Bharathi-DotNet/-Alarm-v1-Esp32/hardware/kicad/pcb_bottom_3d.png

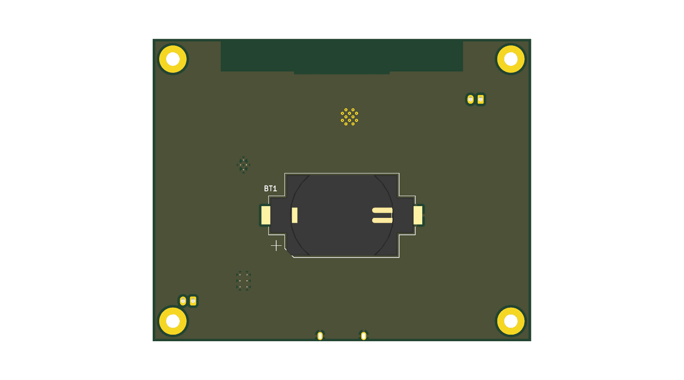
hardware/kicad/pcb_bottom_3d.png
