Bharathi-DotNet/-Alarm-v1-Esp32/hardware/kicad/pcb_top_3d.png

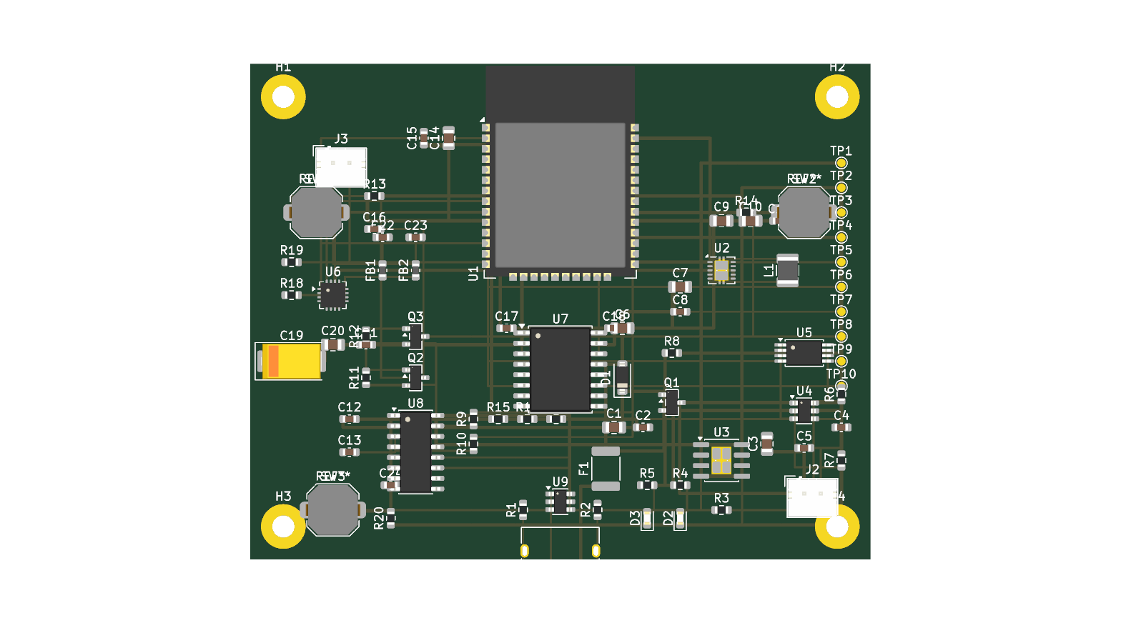
hardware/kicad/pcb_top_3d.png
