Bharathi-DotNet/-Alarm-v1-Esp32/hardware/kicad/alarm_clock_v1_bom.csv

Refs | Value | Footprint | Qty | DNP
BT1 | CR2032 (3V) | Battery:BatteryHolder_Keystone_1060_1x2032 | 1
C1 | 10uF | Capacitor_SMD:C_0805_2012Metric | 1
C2 | 100nF | Capacitor_SMD:C_0603_1608Metric | 1
C3 | 10uF | Capacitor_SMD:C_0805_2012Metric | 1
C4 | 100nF | Capacitor_SMD:C_0603_1608Metric | 1
C5 | 100nF | Capacitor_SMD:C_0603_1608Metric | 1
C6 | 22uF | Capacitor_SMD:C_0805_2012Metric | 1
C7 | 10uF | Capacitor_SMD:C_0805_2012Metric | 1
C8 | 100nF | Capacitor_SMD:C_0603_1608Metric | 1
C9 | 10uF | Capacitor_SMD:C_0805_2012Metric | 1
C10 | 10uF | Capacitor_SMD:C_0805_2012Metric | 1
C11 | 100nF | Capacitor_SMD:C_0603_1608Metric | 1
C12 | 100nF | Capacitor_SMD:C_0603_1608Metric | 1
C13 | 100nF | Capacitor_SMD:C_0603_1608Metric | 1
C14 | 10uF | Capacitor_SMD:C_0805_2012Metric | 1
C15 | 100nF | Capacitor_SMD:C_0603_1608Metric | 1
C16 | 1uF (POR Delay) | Capacitor_SMD:C_0603_1608Metric | 1
C17 | 100nF | Capacitor_SMD:C_0603_1608Metric | 1
C18 | 100nF | Capacitor_SMD:C_0603_1608Metric | 1
C19 | 220uF Low-ESR | Capacitor_Tantalum_SMD:CP_EIA-7343-31_Kemet-D | 1
C20 | 10uF | Capacitor_SMD:C_0805_2012Metric | 1
C21 | 100nF | Capacitor_SMD:C_0603_1608Metric | 1
C22 | 100pF | Capacitor_SMD:C_0603_1608Metric | 1
C23 | 100pF | Capacitor_SMD:C_0603_1608Metric | 1
C24 | 100nF (Debounce) | Capacitor_SMD:C_0603_1608Metric | 1
D1 | SS34 (3A/40V) | Diode_SMD:D_SOD-123 | 1
D2 | RED (CHRG) | LED_SMD:LED_0603_1608Metric | 1
D3 | GRN (FULL) | LED_SMD:LED_0603_1608Metric | 1
F1 | 500mA PTC | Fuse:Fuse_1812_4532Metric | 1
FB1 | 220R@100MHz | Inductor_SMD:L_0603_1608Metric | 1
FB2 | 220R@100MHz | Inductor_SMD:L_0603_1608Metric | 1
J1 | USB_C_16P | Connector_USB:USB_C_Receptacle_HRO_TYPE-C-31-M-12 | 1
J2 | JST_PH_BATT | Connector_JST:JST_PH_B2B-PH-K_1x02_P2.00mm_Vertical | 1
J3 | Speaker_4R_3W | Connector_JST:JST_PH_B2B-PH-K_1x02_P2.00mm_Vertical | 1
L1 | 2.2uH (2.5A) | Inductor_SMD:L_1210_3225Metric | 1
Q1 | AO3401A | Package_TO_SOT_SMD:SOT-23 | 1
Q2 | MMBT3904 | Package_TO_SOT_SMD:SOT-23 | 1
Q3 | MMBT3904 | Package_TO_SOT_SMD:SOT-23 | 1
R1 | 5.1k (CC1) | Resistor_SMD:R_0603_1608Metric | 1
R2 | 5.1k (CC2) | Resistor_SMD:R_0603_1608Metric | 1
R3 | 4.7k (255mA) | Resistor_SMD:R_0603_1608Metric | 1
R4 | 1k | Resistor_SMD:R_0603_1608Metric | 1
R5 | 1k | Resistor_SMD:R_0603_1608Metric | 1
R6 | 100R | Resistor_SMD:R_0603_1608Metric | 1
R7 | 1k | Resistor_SMD:R_0603_1608Metric | 1
R8 | 100k (Gate PD) | Resistor_SMD:R_0603_1608Metric | 1
R9 | 1k | Resistor_SMD:R_0603_1608Metric | 1
R10 | 1k | Resistor_SMD:R_0603_1608Metric | 1
R11 | 10k | Resistor_SMD:R_0603_1608Metric | 1
R12 | 10k | Resistor_SMD:R_0603_1608Metric | 1
R13 | 10k (EN Pullup) | Resistor_SMD:R_0603_1608Metric | 1
R14 | 10k (BOOT Pullup) | Resistor_SMD:R_0603_1608Metric | 1
R15 | 4.7k | Resistor_SMD:R_0603_1608Metric | 1
R16 | 4.7k | Resistor_SMD:R_0603_1608Metric | 1
R17 | 10k | Resistor_SMD:R_0603_1608Metric | 1
R18 | 100k (12dB Gain) | Resistor_SMD:R_0603_1608Metric | 1
R19 | 100k (SD Pull-Down) | Resistor_SMD:R_0603_1608Metric | 1
R20 | 10k (WAKE Pullup) | Resistor_SMD:R_0603_1608Metric | 1
SW1 | RESET | Button_Switch_SMD:SW_Push_1TS009xxxx-xxxx-xxxx_6x6x5mm | 1
SW2 | BOOT | Button_Switch_SMD:SW_Push_1TS009xxxx-xxxx-xxxx_6x6x5mm | 1
SW3 | WAKE_BTN | Button_Switch_SMD:SW_Push_1TS009xxxx-xxxx-xxxx_6x6x5mm | 1
TP1 | VBUS | TestPoint:TestPoint_Pad_D1.0mm | 1
TP2 | VBAT_PROT | TestPoint:TestPoint_Pad_D1.0mm | 1
TP3 | VSYS | TestPoint:TestPoint_Pad_D1.0mm | 1
TP4 | +3V3 | TestPoint:TestPoint_Pad_D1.0mm | 1
TP5 | GND | TestPoint:TestPoint_Pad_D1.0mm | 1
TP6 | ESP_EN | TestPoint:TestPoint_Pad_D1.0mm | 1
TP7 | ESP_IO0 | TestPoint:TestPoint_Pad_D1.0mm | 1
TP8 | RTC_INT | TestPoint:TestPoint_Pad_D1.0mm | 1
TP9 | WAKE_BTN | TestPoint:TestPoint_Pad_D1.0mm | 1
TP10 | AMP_SD | TestPoint:TestPoint_Pad_D1.0mm | 1
U1 | ESP32-WROOM-32E | RF_Module:ESP32-WROOM-32E | 1
U2 | TPS63001 | Package_SON:Texas_DRC0010J_ThermalVias | 1
U3 | TP4056 | Package_SO:SOIC-8-1EP_3.9x4.9mm_P1.27mm_EP2.41x3.3mm_ThermalVias | 1
U4 | DW01A | Package_TO_SOT_SMD:SOT-23-6 | 1
U5 | FS8205A | Package_SO:TSSOP-8_4.4x3mm_P0.65mm | 1
U6 | MAX98357A | Package_DFN_QFN:TQFN-16-1EP_3x3mm_P0.5mm_EP1.6x1.6mm | 1
U7 | DS3231M | Package_SO:SOIC-16W_7.5x10.3mm_P1.27mm | 1
U8 | CH340C | Package_SO:SOIC-16_3.9x9.9mm_P1.27mm | 1
U9 | USBLC6-2SC6 | Package_TO_SOT_SMD:SOT-23-6 | 1
