Bharathi-DotNet/-Alarm-v1-Esp32/hardware/kicad/test_rect.png

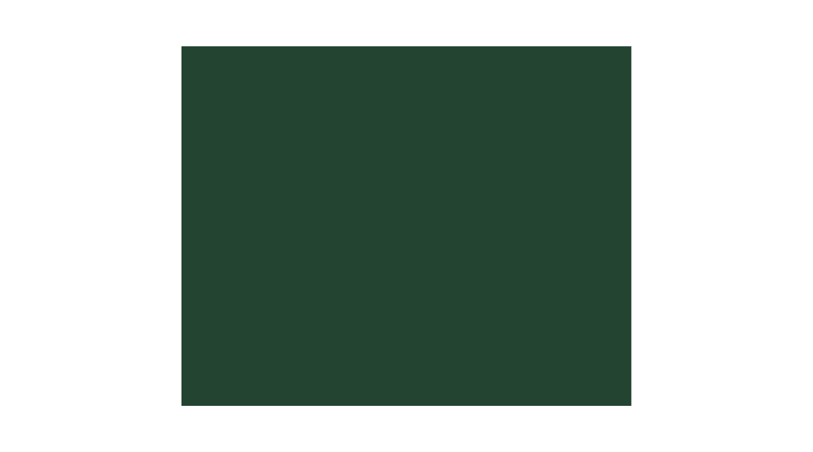
hardware/kicad/test_rect.png
