Bharathi-DotNet/-Alarm-v1-Esp32/hardware/kicad/alarm_clock_v1.pdf

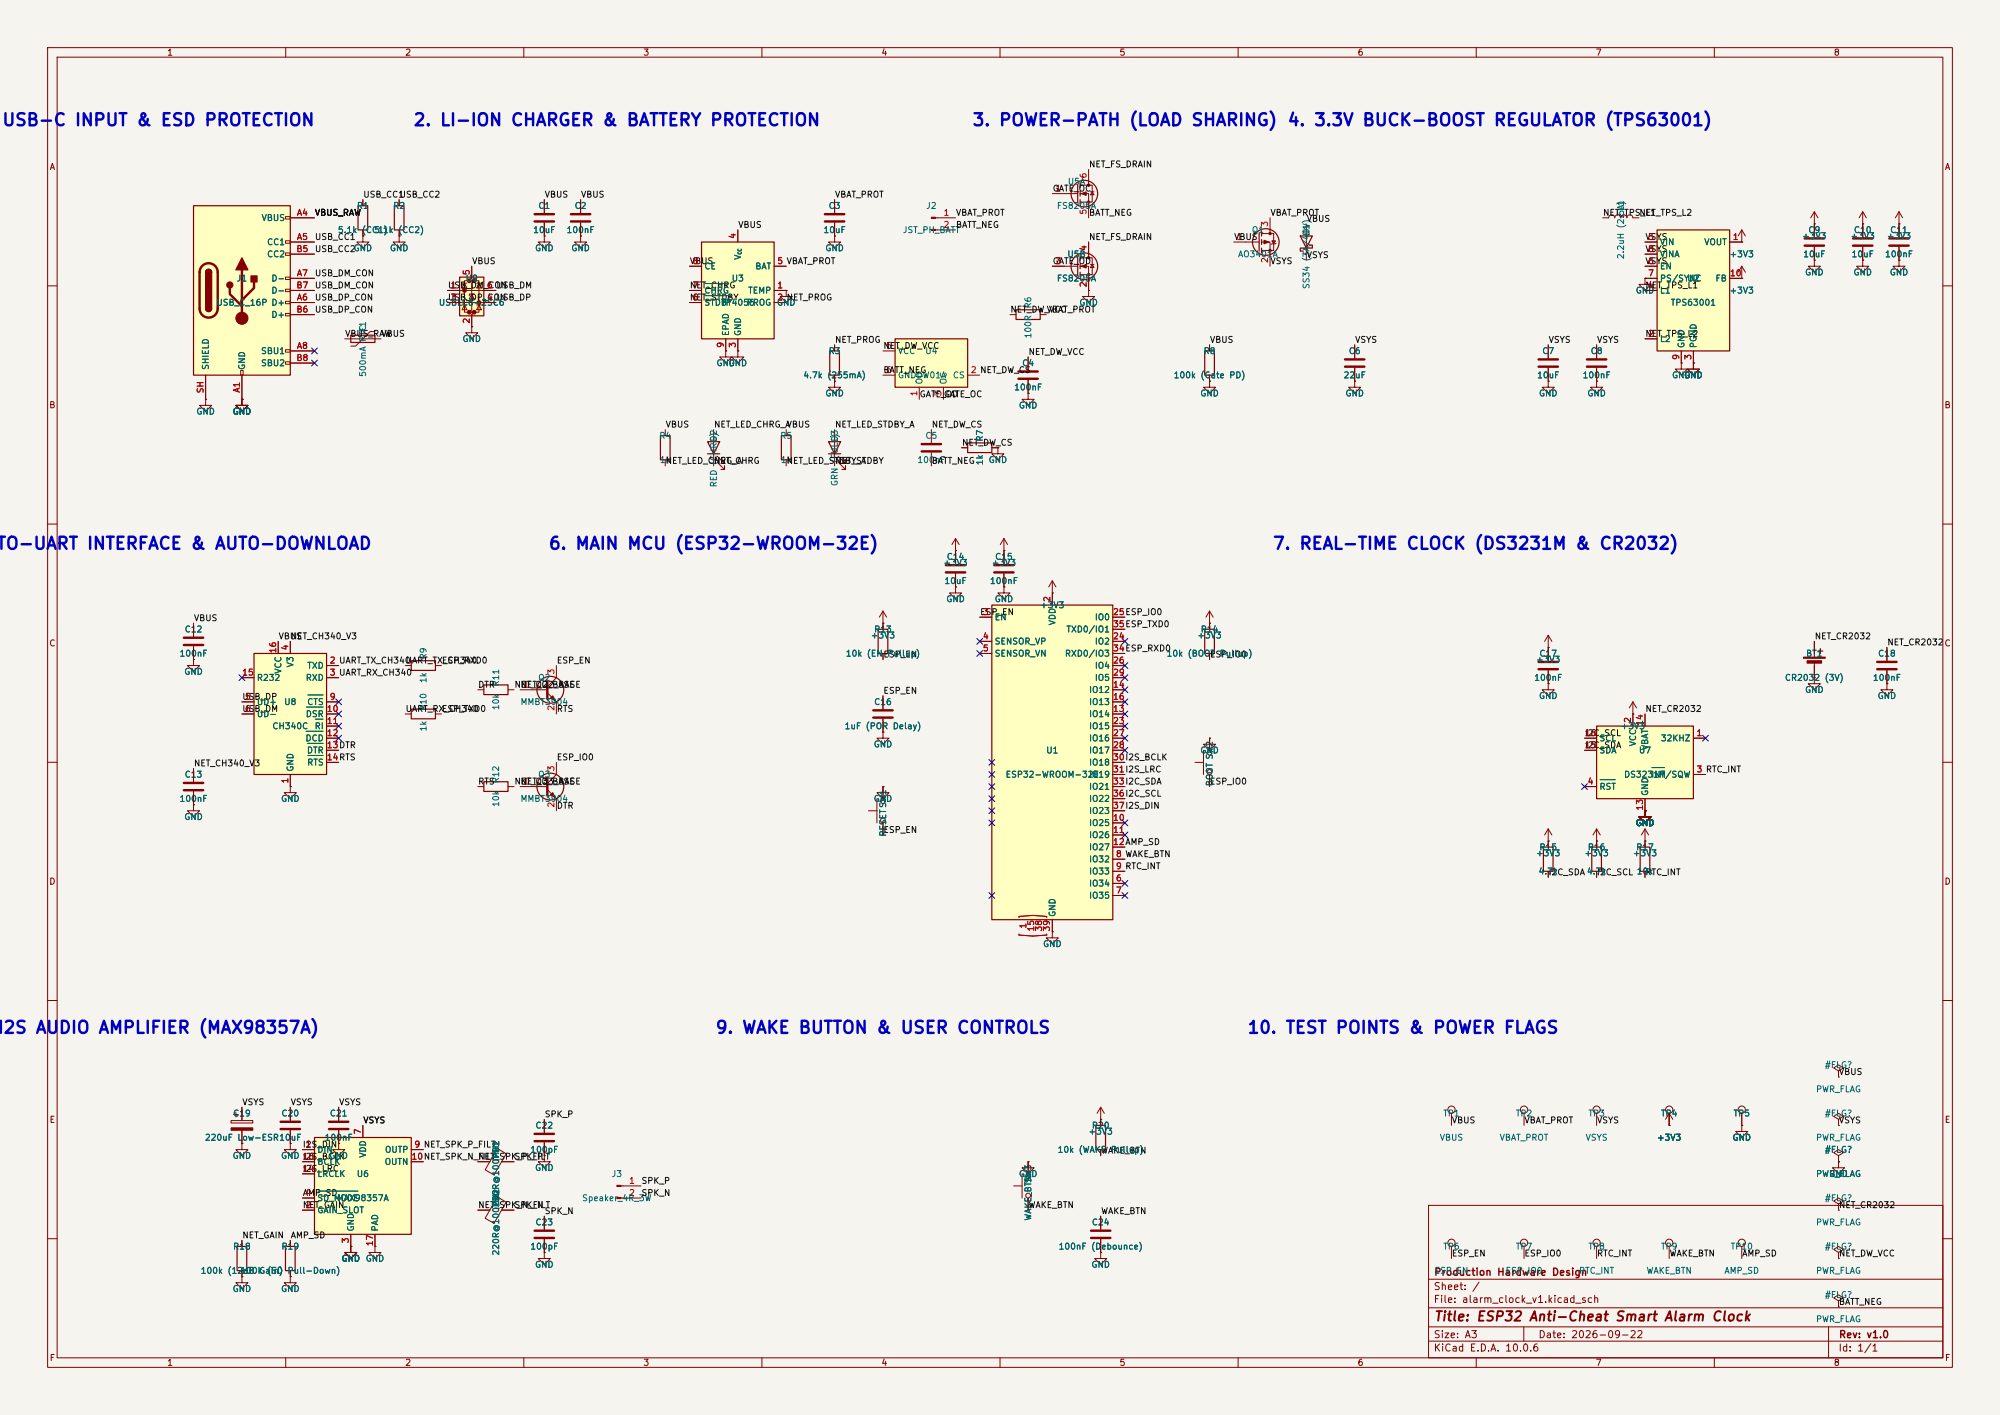
[picture p5: page 1]

2. LI-ION CHARGER & BATTERY PROTECTION

4 UD+ 5 UD- 6 CTS 9 DSR 10 RI 11 DCD 12 DTR 13 RTS 14 R232 15 VCC 16 R3

10k (WAKE Pullup) D3 GRN (FULL)

5. USB-TO-UART INTERFACE & AUTO-DOWNLOAD

4 UD+ 5 UD- 6 CTS 9 DSR 10 RI 11 DCD 12 DTR 13 RTS 14 R232 15 VCC 16 U8 CH340C R12 10k GND

9. WAKE BUTTON & USER CONTROLS

10. TEST POINTS & POWER FLAGS

100k (SD Pull-Down) GND

Production Hardware Design
Sheet: /
File: alarm_clock_v1.kicad_sch
Title: ESP32 Anti-Cheat Smart Alarm Clock

Size: A3 | Rev: v1.0 | F Date: 2026-09-22
KiCad E.D.A. 10.0.6 | Id: 1/1
