Bharathi-DotNet/-Alarm-v1-Esp32/hardware/kicad/alarm_clock_v1_pcb.pdf

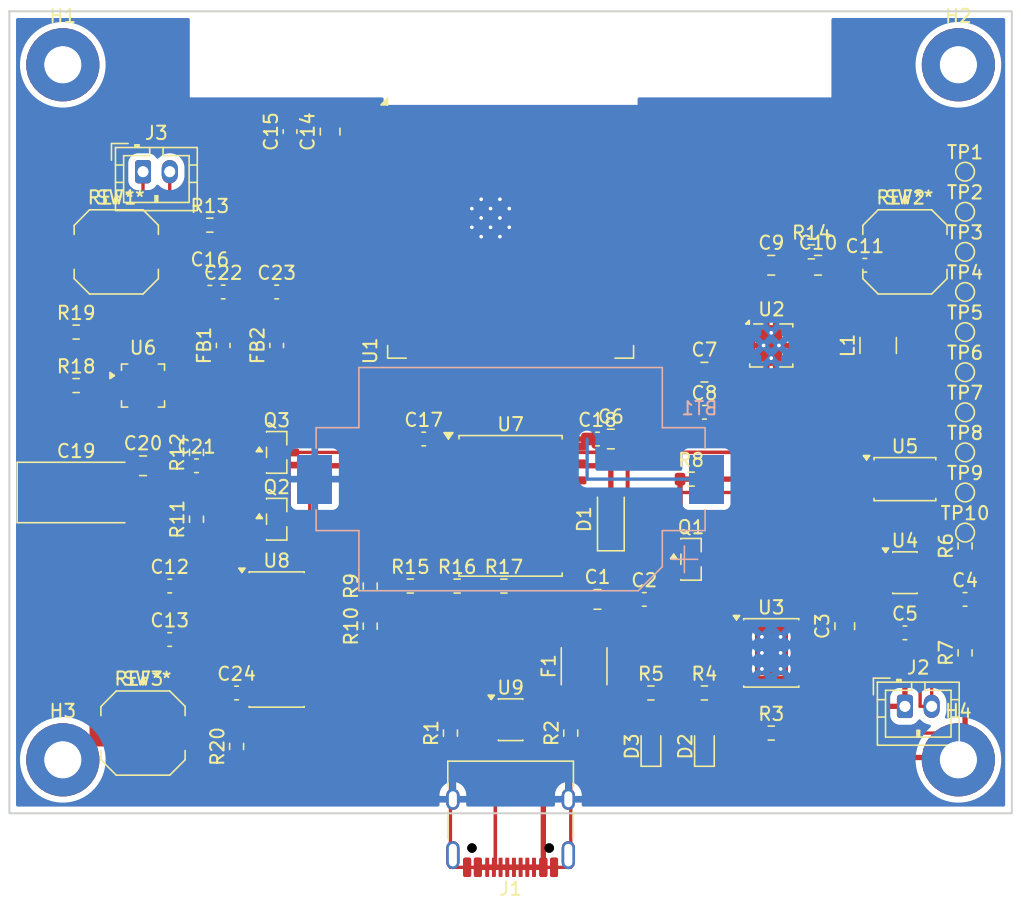
[picture p6: page 1]
