Bharathi-DotNet/-Alarm-v1-Esp32/hardware/kicad/alarm_clock_v1.kicad_pcb

## KiCad design hardware/kicad/alarm_clock_v1.kicad_pcb (2026-10-11)

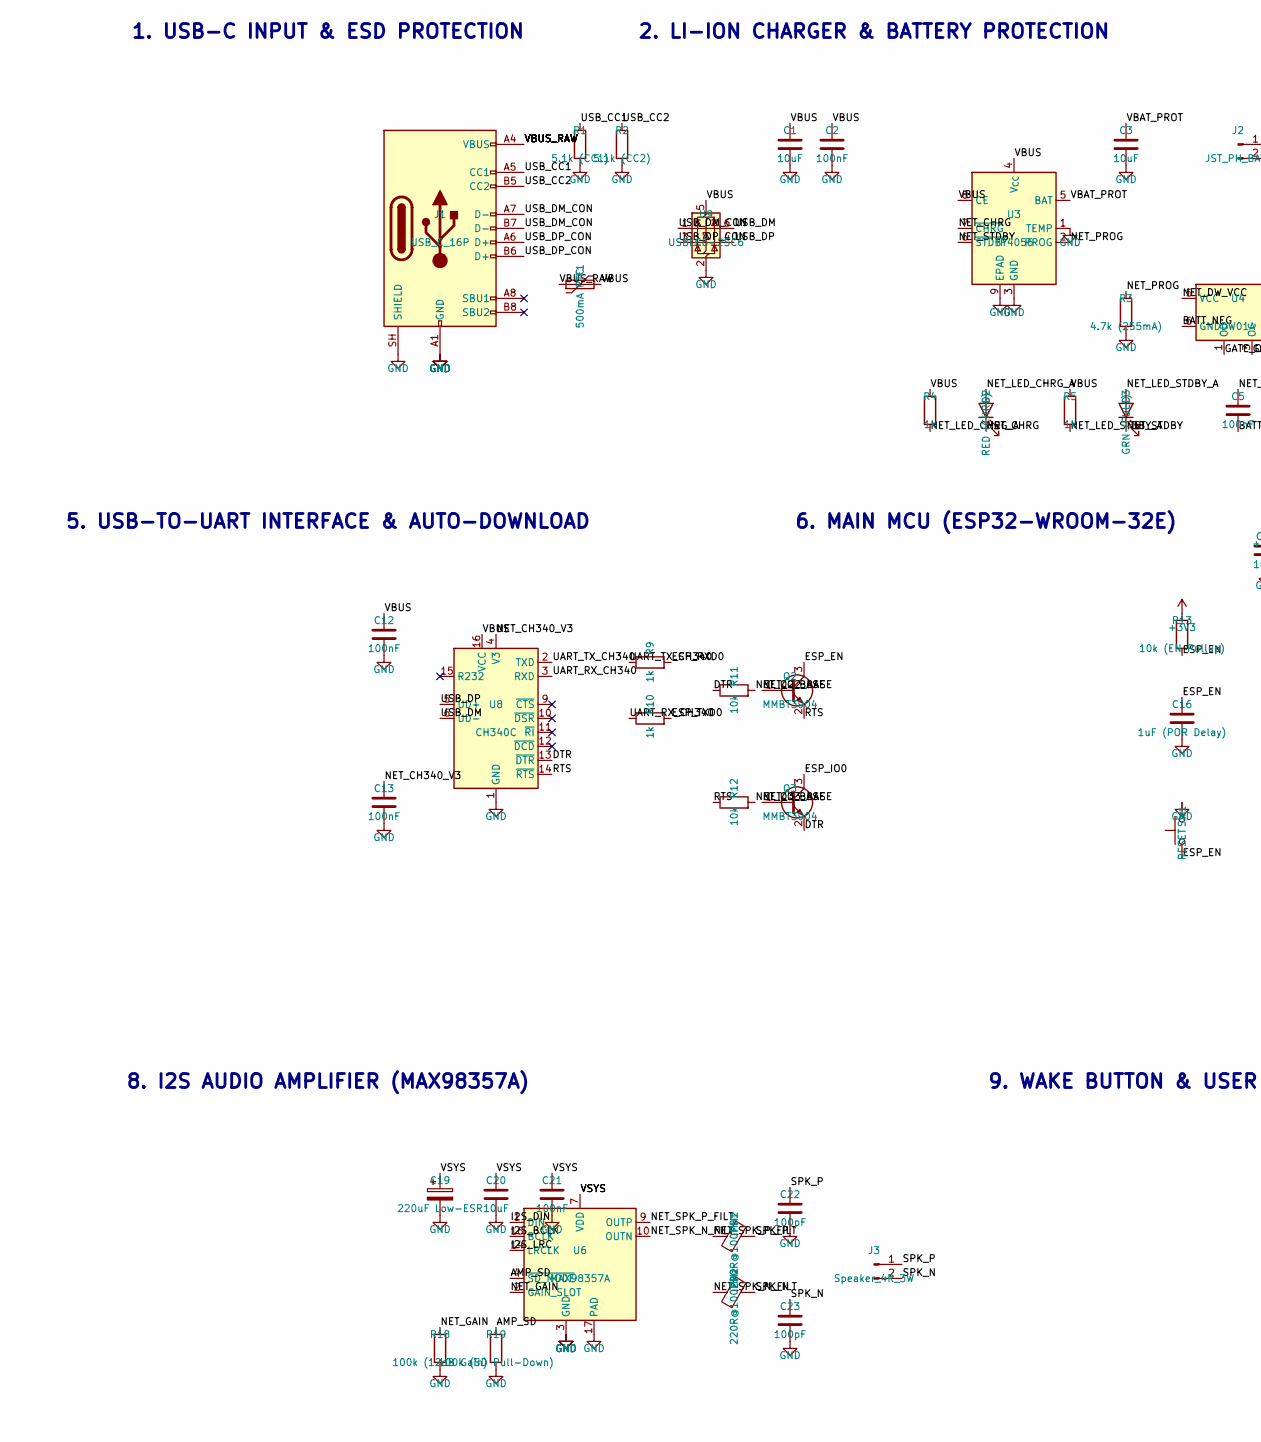
[picture p7: schematic alarm_clock_v1.kicad_sch, ESP32 Anti-Cheat Smart Alarm Clock, part in row 1, column 1]

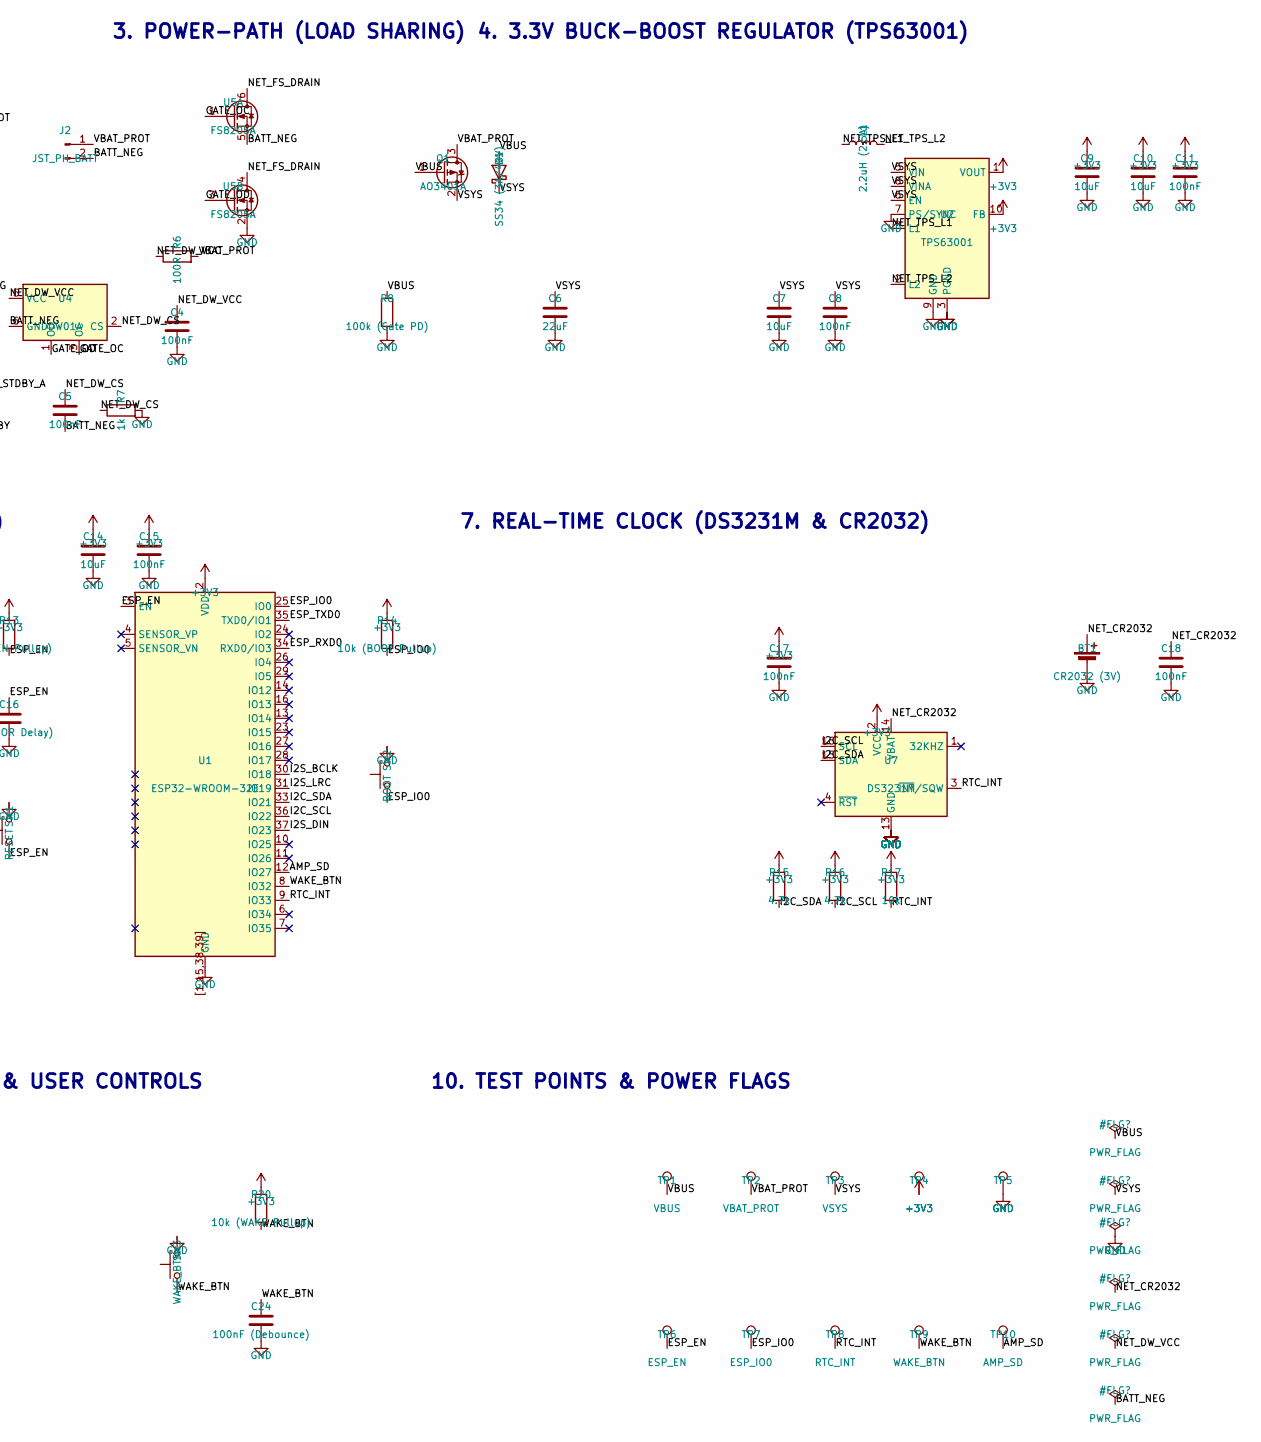
[picture p8: schematic alarm_clock_v1.kicad_sch, ESP32 Anti-Cheat Smart Alarm Clock, part in row 1, column 2]

Parts:
BT1: CR2032 (3V); BatteryHolder_Keystone_1060_1x2032
C1, C3, C7, C9, C10, C14, C20: 10uF; C_0805_2012Metric
C2, C4, C5, C8, C11, C12, C13, C15, C17, C18, C21: 100nF; C_0603_1608Metric
C6: 22uF; C_0805_2012Metric
C16: 1uF (POR Delay); C_0603_1608Metric
C19: 220uF Low-ESR; CP_EIA-7343-31_Kemet-D
C22, C23: 100pF; C_0603_1608Metric
C24: 100nF (Debounce); C_0603_1608Metric
D1: SS34 (3A/40V); D_SOD-123
D2: RED (CHRG); LED_0603_1608Metric
D3: GRN (FULL); LED_0603_1608Metric
F1: 500mA PTC; Fuse_1812_4532Metric
FB1, FB2: 220R@100MHz; L_0603_1608Metric
J1: USB_C_16P; USB_C_Receptacle_HRO_TYPE-C-31-M-12
J2: JST_PH_BATT; JST_PH_B2B-PH-K_1x02_P2.00mm_Vertical
J3: Speaker_4R_3W; JST_PH_B2B-PH-K_1x02_P2.00mm_Vertical
L1: 2.2uH (2.5A); L_1210_3225Metric
Q1: AO3401A; SOT-23
Q2, Q3: MMBT3904; SOT-23
R1: 5.1k (CC1); R_0603_1608Metric
R2: 5.1k (CC2); R_0603_1608Metric
R3: 4.7k (255mA); R_0603_1608Metric
R4, R5, R7, R9, R10: 1k; R_0603_1608Metric
R6: 100R; R_0603_1608Metric
R8: 100k (Gate PD); R_0603_1608Metric
R11, R12, R17: 10k; R_0603_1608Metric
R13: 10k (EN Pullup); R_0603_1608Metric
R14: 10k (BOOT Pullup); R_0603_1608Metric
R15, R16: 4.7k; R_0603_1608Metric
R18: 100k (12dB Gain); R_0603_1608Metric
R19: 100k (SD Pull-Down); R_0603_1608Metric
R20: 10k (WAKE Pullup); R_0603_1608Metric
SW1: RESET; SW_Push_1TS009xxxx-xxxx-xxxx_6x6x5mm
SW2: BOOT; SW_Push_1TS009xxxx-xxxx-xxxx_6x6x5mm
SW3: WAKE_BTN; SW_Push_1TS009xxxx-xxxx-xxxx_6x6x5mm
TP1: VBUS; TestPoint_Pad_D1.0mm
TP2: VBAT_PROT; TestPoint_Pad_D1.0mm
TP3: VSYS; TestPoint_Pad_D1.0mm
TP4: +3V3; TestPoint_Pad_D1.0mm
TP5: GND; TestPoint_Pad_D1.0mm
TP6: ESP_EN; TestPoint_Pad_D1.0mm
TP7: ESP_IO0; TestPoint_Pad_D1.0mm
TP8: RTC_INT; TestPoint_Pad_D1.0mm
TP9: WAKE_BTN; TestPoint_Pad_D1.0mm
TP10: AMP_SD; TestPoint_Pad_D1.0mm
U1: ESP32-WROOM-32E
U2: TPS63001; Texas_DRC0010J_ThermalVias
U3: TP4056; SOIC-8-1EP_3.9x4.9mm_P1.27mm_EP2.41x3.3mm_ThermalVias
U4: DW01A; SOT-23-6
U5: FS8205A; TSSOP-8_4.4x3mm_P0.65mm
U6: MAX98357A; TQFN-16-1EP_3x3mm_P0.5mm_EP1.6x1.6mm
U7: DS3231M; SOIC-16W_7.5x10.3mm_P1.27mm
U8: CH340C; SOIC-16_3.9x9.9mm_P1.27mm
U9: USBLC6-2SC6; SOT-23-6

Connections:
+3V3: C9.1, C10.1, C11.1, C14.1, C15.1, C17.1, R13.1, R14.1, R15.1, R16.1, R17.1, R20.1, TP4.1, U1.2 (VDD), U2.1 (VOUT), U2.10 (FB), U7.2 (VCC)
/AMP_SD: R19.1, TP10.1, U1.12 (IO27), U6.4 (~SD_MODE)
/BATT_NEG: C5.2, J2.2, U4.6 (GND), U5.5 (S)
/DTR: Q3.2 (E), R11.1, U8.13 (~DTR)
/ESP_EN: C16.1, Q2.3 (C), R13.2, SW1.1, TP6.1, U1.3 (EN)
/ESP_IO0: Q3.3 (C), R14.2, SW2.1, TP7.1, U1.25 (IO0)
/ESP_RXD0: R9.2, U1.34 (RXD0/IO3)
/ESP_TXD0: R10.2, U1.35 (TXD0/IO1)
/GATE_OC: U4.3 (OC), U5.1 (G)
/GATE_OD: U4.1 (OD), U5.3 (G)
/I2C_SCL: R16.2, U1.36 (IO22), U7.16 (SCL)
/I2C_SDA: R15.2, U1.33 (IO21), U7.15 (SDA)
/I2S_BCLK: U1.30 (IO18), U6.16 (BCLK)
/I2S_DIN: U1.37 (IO23), U6.1 (DIN)
/I2S_LRC: U1.31 (IO19), U6.14 (LRCLK)
/NET_CH340_V3: C13.1, U8.4 (V3)
/NET_CHRG: D2.1 (K), U3.7 (~CHRG)
/NET_CR2032: BT1.1 (+), C18.1, U7.14 (VBAT)
/NET_DW_CS: C5.1, R7.1, U4.2 (CS)
/NET_DW_VCC: C4.1, R6.1, U4.5 (VCC)
/NET_FS_DRAIN: U5.4 (D), U5.6 (D)
/NET_GAIN: R18.1, U6.2 (GAIN_SLOT)
/NET_LED_CHRG_A: D2.2 (A), R4.2
/NET_LED_STDBY_A: D3.2 (A), R5.2
/NET_PROG: R3.1, U3.2 (PROG)
/NET_Q2_BASE: Q2.1 (B), R11.2
/NET_Q3_BASE: Q3.1 (B), R12.2
/NET_SPK_N_FILT: FB2.1, U6.10 (OUTN)
/NET_SPK_P_FILT: FB1.1, U6.9 (OUTP)
/NET_STDBY: D3.1 (K), U3.6 (~STDBY)
/NET_TPS_L1: L1.1, U2.4 (L1)
/NET_TPS_L2: L1.2, U2.2 (L2)
/RTC_INT: R17.2, TP8.1, U1.9 (IO33), U7.3 (~INT/SQW)
/RTS: Q2.2 (E), R12.1, U8.14 (~RTS)
/SPK_N: C23.1, FB2.2, J3.2
/SPK_P: C22.1, FB1.2, J3.1
/UART_RX_CH340: R10.1, U8.3 (RXD)
/UART_TX_CH340: R9.1, U8.2 (TXD)
/USB_CC1: J1.A5 (CC1), R1.1
/USB_CC2: J1.B5 (CC2), R2.1
/USB_DM: U8.6 (UD-), U9.6 (I/O1)
/USB_DM_CON: J1.A7 (D-), J1.B7 (D-), U9.1 (I/O1)
/USB_DP: U8.5 (UD+), U9.4 (I/O2)
/USB_DP_CON: J1.A6 (D+), J1.B6 (D+), U9.3 (I/O2)
/VBAT_PROT: C3.1, J2.1, Q1.3 (D), R6.2, TP2.1, U3.5 (BAT)
/VBUS: C1.1, C2.1, C12.1, D1.2 (A), F1.2, Q1.1 (G), R4.1, R5.1, R8.1, TP1.1, U3.4 (V_{CC}), U3.8 (CE), U8.16 (VCC), U9.5 (VBUS)
/VBUS_RAW: F1.1, J1.A4 (VBUS), J1.A9 (VBUS), J1.B4 (VBUS), J1.B9 (VBUS)
/VSYS: C6.1, C7.1, C8.1, C19.1, C20.1, C21.1, D1.1 (K), Q1.2 (S), TP3.1, U2.5 (VIN), U2.6 (EN), U2.8 (VINA), U6.7 (VDD), U6.8 (VDD)
/WAKE_BTN: C24.1, R20.2, SW3.1, TP9.1, U1.8 (IO32)
GND: BT1.2 (-), C1.2, C2.2, C3.2, C4.2, C6.2, C7.2, C8.2, C9.2, C10.2, C11.2, C12.2, C13.2, C14.2, C15.2, C16.2, C17.2, C18.2, C19.2, C20.2, C21.2, C22.2, C23.2, C24.2, J1.A1 (GND), J1.A12 (GND), J1.B1 (GND), J1.B12 (GND), J1.SH (SHIELD), R1.2, R2.2, R3.2, R7.2, R8.2, R18.2, R19.2, SW1.2, SW2.2, SW3.2, TP5.1, U1.1, U1.15, U1.38, U1.39, U1.[1,15,38,39] (GND), U2.3 (PGND), U2.7 (PS/SYNC), U2.9 (GND), U2.11 (PGND), U3.1 (TEMP), U3.3 (GND), U3.9 (EPAD), U5.2 (S), U6.3 (GND), U6.11 (GND), U6.15 (GND), U6.17 (PAD), U7.5 (GND), U7.6 (GND), U7.7 (GND), U7.8 (GND), U7.9 (GND), U7.10 (GND), U7.11 (GND), U7.12 (GND), U7.13 (GND), U8.1 (GND), U9.2 (GND)

Notes on the sheet:
1. USB-C INPUT & ESD PROTECTION
2. LI-ION CHARGER & BATTERY PROTECTION
3. POWER-PATH (LOAD SHARING)
4. 3.3V BUCK-BOOST REGULATOR (TPS63001)
5. USB-TO-UART INTERFACE & AUTO-DOWNLOAD
6. MAIN MCU (ESP32-WROOM-32E)
7. REAL-TIME CLOCK (DS3231M & CR2032)
8. I2S AUDIO AMPLIFIER (MAX98357A)
9. WAKE BUTTON & USER CONTROLS
10. TEST POINTS & POWER FLAGS

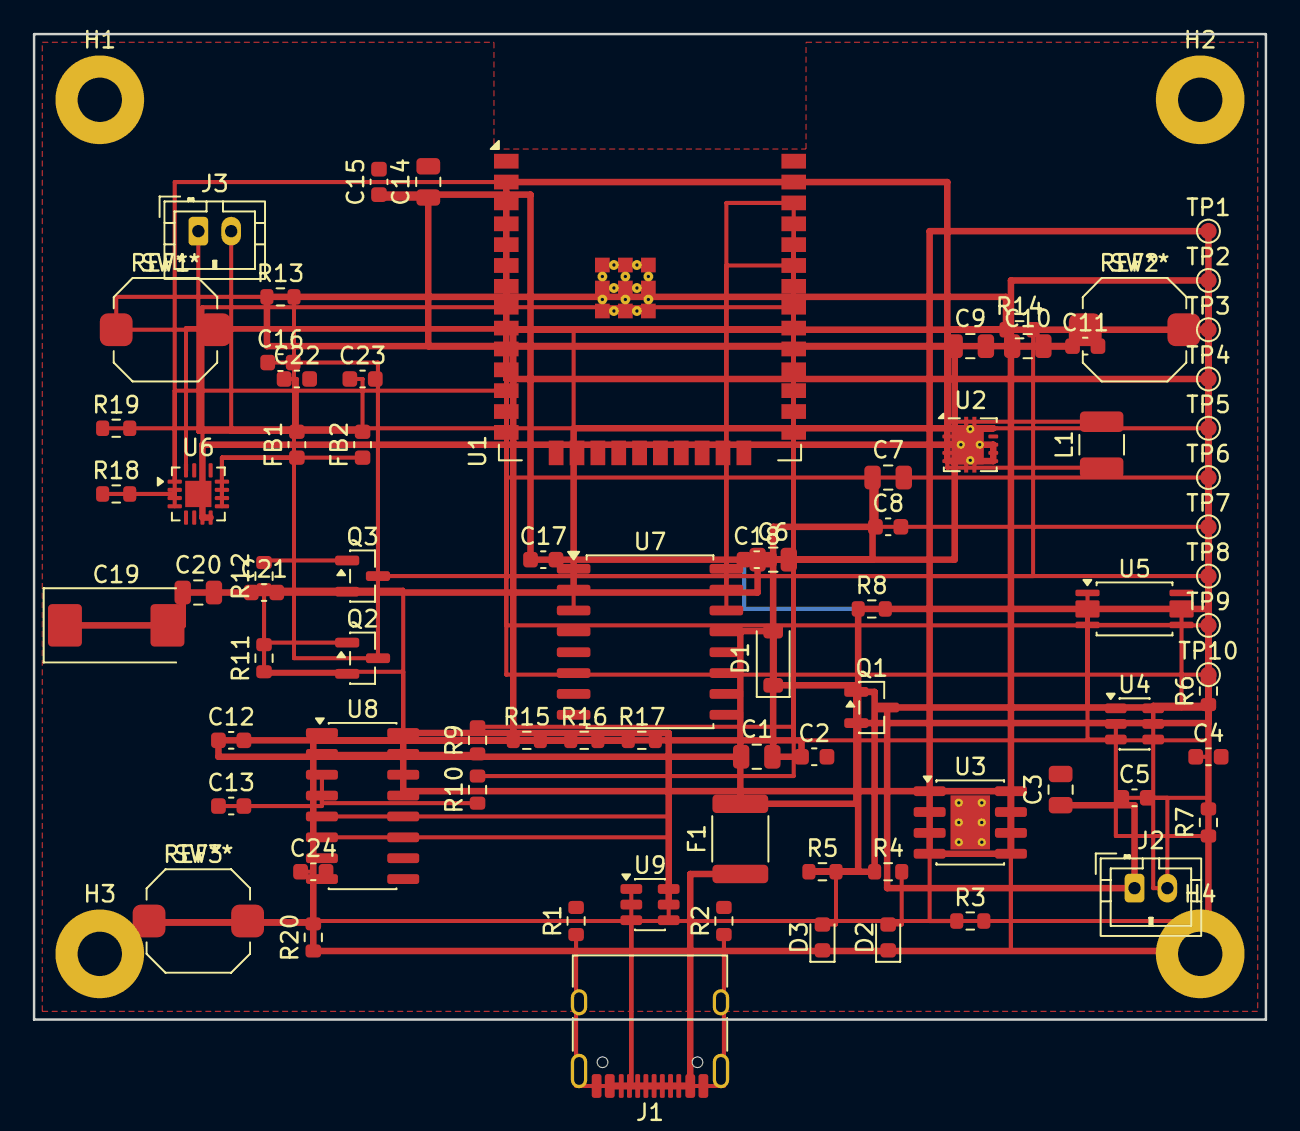
[picture p9: board alarm_clock_v1.kicad_pcb from above]

Board: 2 copper layers, 75.0 x 60.0 mm, 84 parts (1 on the bottom side), 50 nets.

Other parts of the board:
H1, H2, H3, H4: MountingHole_2.7mm_M2.5_Pad
