Bharathi-DotNet/-Alarm-v1-Esp32/hardware/kicad/test_grid_arith.py

print("123.19 / 1.27 =", 123.19 / 1.27)
print("123.19 / 2.54 =", 123.19 / 2.54)
print("round(123.19 / 2.54) * 2.54 =", round(123.19 / 2.54) * 2.54)
print("round(123.19 / 1.27) * 1.27 =", round(123.19 / 1.27) * 1.27)
