Bharathi-DotNet/-Alarm-v1-Esp32/(commit log)

2026-09-12 Version 1 stage-1
2026-09-12 V1 stage-2 backup QR attached for emergency and and parent password
2026-09-13 V1 stage 3 custom song alarm and bluetooth connected device voice attached
2026-09-19 first time using Antigravity Test files - battery optimization using deep sleep method
2026-10-20 last version stage 2
